louis-tk/mini-rack/README.md

# Louis TK mini-rack 10" mounts
### [mikrotik_L009](./mikrotik_L009/):
- MikroTik L009UiGS-RM
- MikroTik L009UiGS-2HaxD-IN
- MikroTik RB5009UG+S+IN
- MikroTik RB5009UPr+S+IN
### [geekworm_X1011_4xNVMe](./geekworm_X1011_4xNVMe/)
- Geekworm X1011 4 x NVMe base, with Raspberry Pi 5 1U
