louis-tk/mini-rack/geekworm_X1011_4xNVMe/README.md

# [Geekworm X1011 PCIe 4 x NVMe](./STLs/geekworm_X1011_4xNVMe_10in_1U.stl)

This setup uses the [Geekworm X1011 PCIe board](https://www.amazon.co.uk/Geekworm-X1011-Peripheral-Raspberry-Support/dp/B0D6YRHNG5) and a Raspberry Pi 5 for a compact home NAS.

## Work in Progress
This is still a work in progress and I am yet to get this STL printed and check fitment.

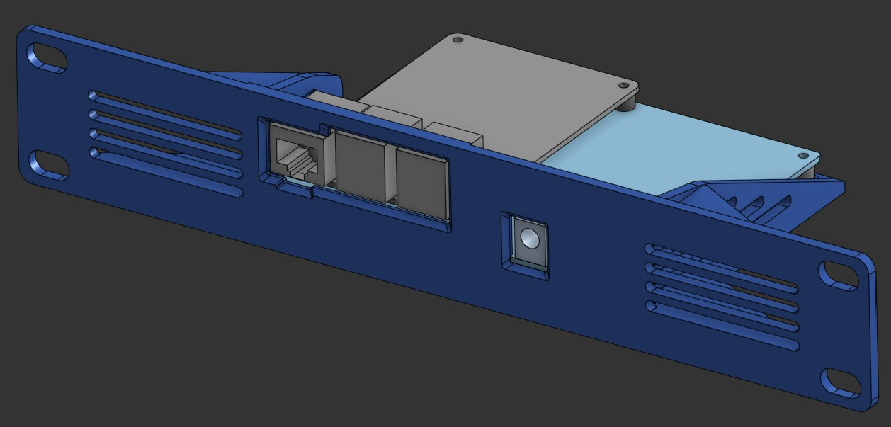
[picture p5: geekworm_X1011_4xNVMe/images/01.jpg]

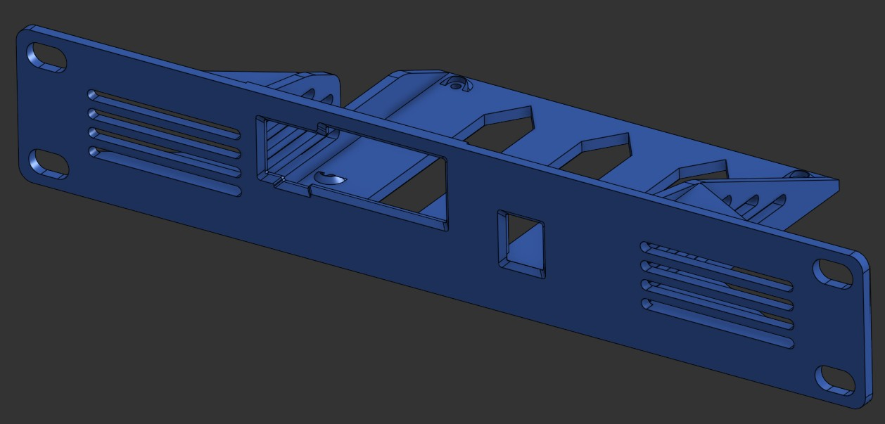
[picture p6: geekworm_X1011_4xNVMe/images/02.jpg]

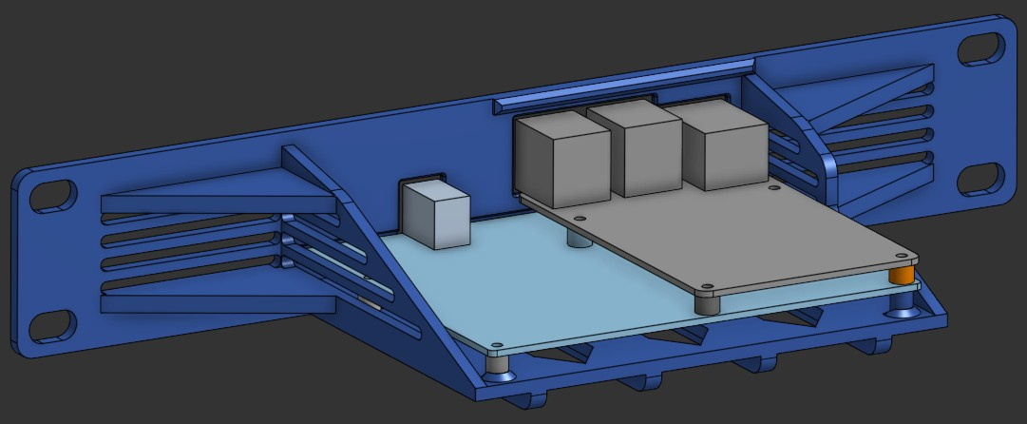
[picture p7: geekworm_X1011_4xNVMe/images/03.jpg]

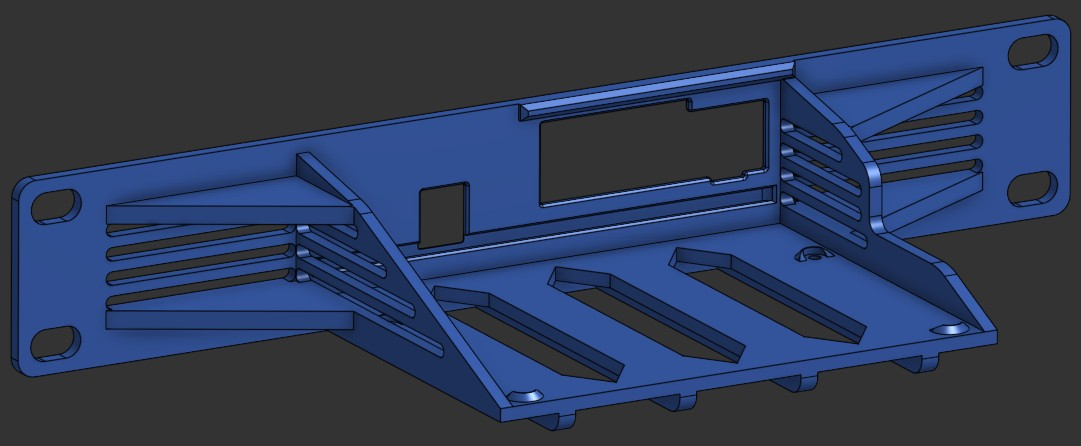
[picture p8: geekworm_X1011_4xNVMe/images/04.jpg]
