louis-tk/mini-rack/geekworm_X1011_4xNVMe/STLs/geekworm_X1011_4xNVMe_10in_1U.stl

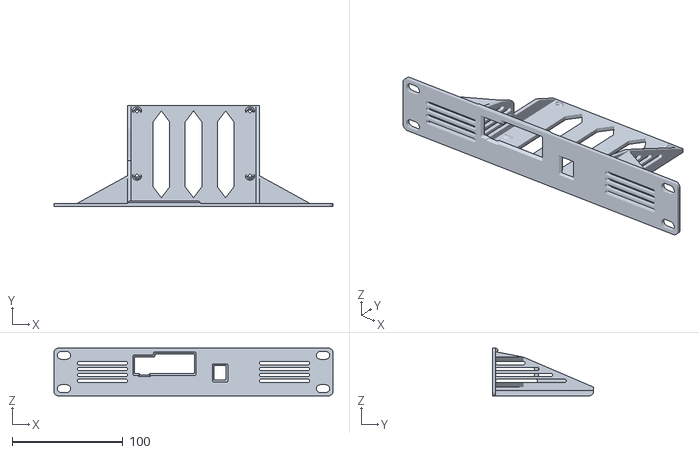
[picture p9: CAD file, 2026-04-18]
geekworm_X1011_4xNVMe/STLs/geekworm_X1011_4xNVMe_10in_1U.stl
252.0 x 91.5 x 43.0
