louis-tk/mini-rack/mikrotik_L009/STLs/mikrotik_L009_10in_1U.stl

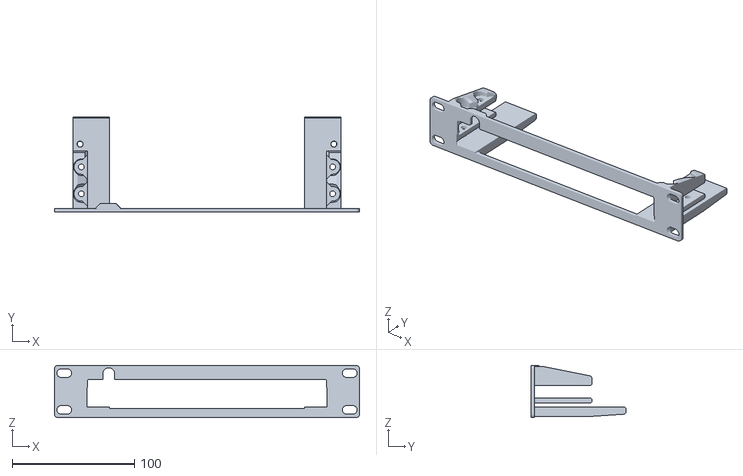
[picture p10: CAD file, 2026-04-18]
mikrotik_L009/STLs/mikrotik_L009_10in_1U.stl
250.0 x 78.0 x 43.0
