louis-tk/mini-rack/(list of files, cad)

Other CAD files:
mikrotik_L009/STLs/mikrotik_L009_10in_1U_no_cable_hole.stl
