louis-tk/mini-rack/(commit log)

2026-04-18 Add Mikrotik L009 Mount
    [Mikrotik - L009 - 10in - no cable hole.stl, Mikrotik - L009 - 10in.stl]
2026-04-18 Add mount photo
2026-04-18 Add geekworm NAS mount.
    [geekworm_X1011_4xNVMe_10in.stl, mikrotik_L009_10in.stl, mikrotik_L009_10in_no_cable_hole.stl]
2026-04-18 Update names
    [geekworm_X1011_4xNVMe_10in_1U.stl, mikrotik_L009_10in_1U.stl, mikrotik_L009_10in_1U_no_cable_hole.stl]
